chuanjianghe1024-cmd/fc-sensor-models/assets/bh1750-gy302/model.step

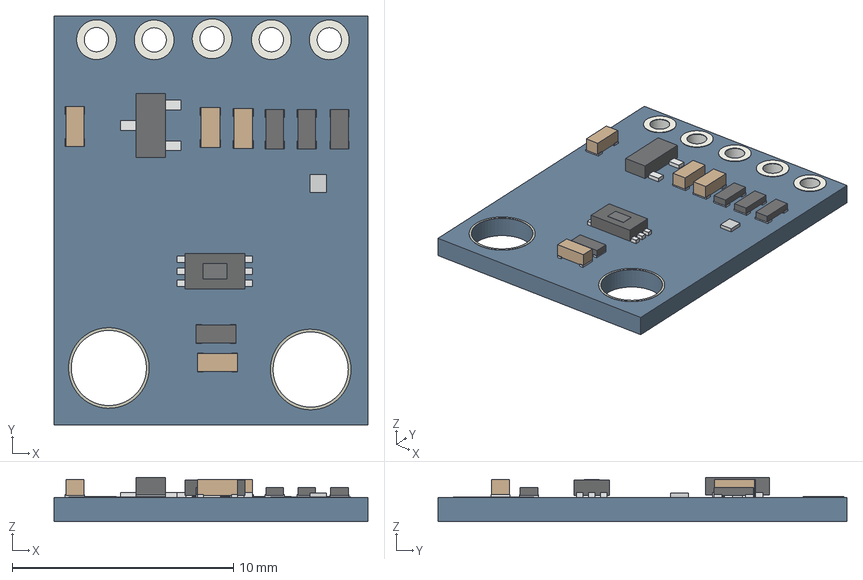
[picture p4: CAD file, 2026-10-26]
assets/bh1750-gy302/model.step
14.2 x 18.5 x 2.00 mm
PCB_14p2x18p5x1p1
P1_plated_hole
P1_top_pad
P1_bottom_pad
P2_plated_hole
P2_top_pad
P2_bottom_pad
P3_plated_hole
P3_top_pad
P3_bottom_pad
P4_plated_hole
P4_top_pad
P4_bottom_pad
P5_plated_hole
P5_top_pad
P5_bottom_pad
H1_rim
H2_rim
Cap_left
Cap_left_endA
Cap_left_endB
Cap_row_1
Cap_row_1_endA
Cap_row_1_endB
Cap_row_2
Cap_row_2_endA
Cap_row_2_endB
Res_row_1
Res_row_1_endA
Res_row_1_endB
Res_row_2
Res_row_2_endA
Res_row_2_endB
Res_row_3
Res_row_3_endA
Res_row_3_endB
Res_near_holes
Res_near_holes_endL
Res_near_holes_endR
Cap_near_holes
Cap_near_holes_endL
Cap_near_holes_endR
Regulator_body
Regulator_lead_1
Regulator_lead_2
Regulator_lead_3
BH1750_body_reference
Sensor_lead_-1_0
Sensor_lead_-1_1
Sensor_lead_-1_2
Sensor_lead_1_0
Sensor_lead_1_1
Sensor_lead_1_2
Optical_region_visual_marker
Solder_bridge_reference
