chuanjianghe1024-cmd/fc-sensor-models/assets/esp32-c3-supermini/model.stl

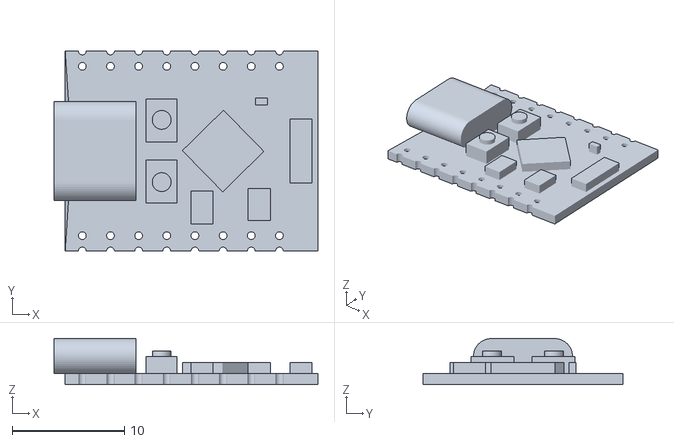
[picture p5: CAD file, 2026-10-26]
assets/esp32-c3-supermini/model.stl
23.5 x 17.8 x 4.10
