chuanjianghe1024-cmd/fc-sensor-models/fc-enclosure/print/step/02_Front_hook_single.step

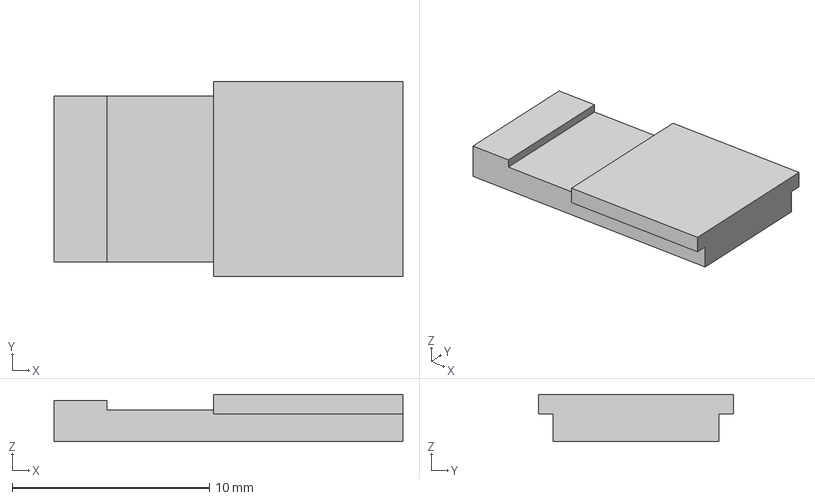
[picture p6: CAD file, 2026-10-26]
fc-enclosure/print/step/02_Front_hook_single.step
17.7 x 9.90 x 2.40 mm
