chuanjianghe1024-cmd/fc-sensor-models/fc-enclosure/print/step/01_Base_single.step

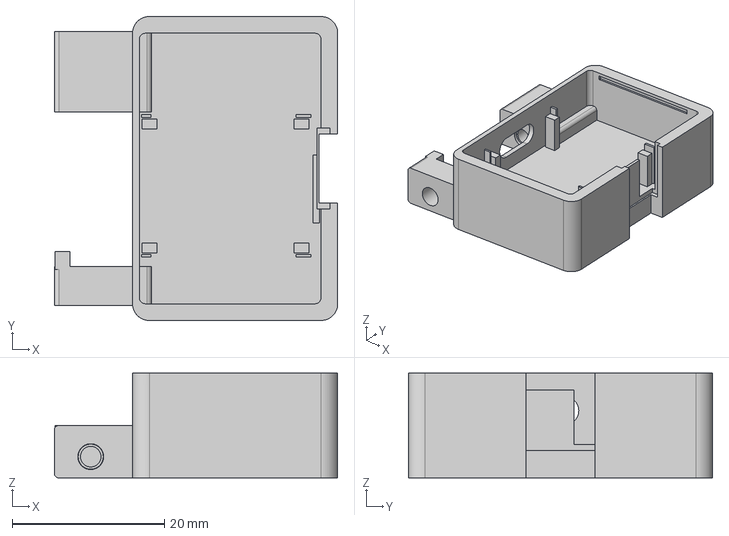
[picture p8: CAD file, 2026-10-26]
fc-enclosure/print/step/01_Base_single.step
37.3 x 40.0 x 13.8 mm
