chuanjianghe1024-cmd/fc-sensor-models/fc-enclosure/print/step/03_H_leg_single.step

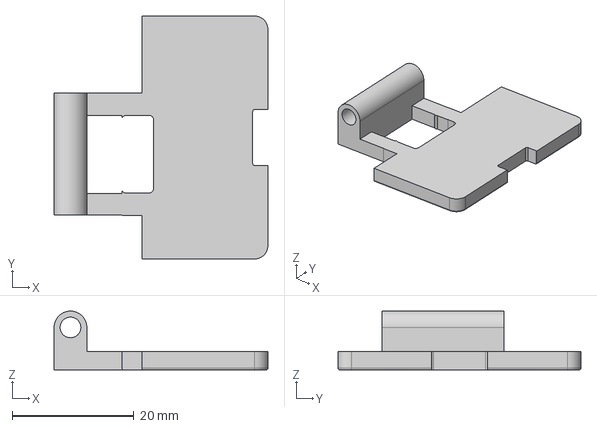
[picture p9: CAD file, 2026-10-26]
fc-enclosure/print/step/03_H_leg_single.step
35.2 x 40.0 x 9.70 mm
