chuanjianghe1024-cmd/fc-sensor-models/fc-enclosure/print/step/04_Lid_color.step

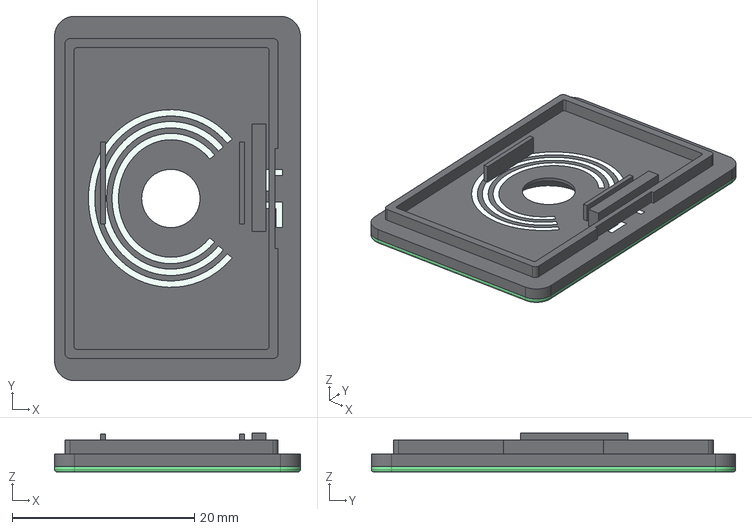
[picture p11: CAD file, 2026-10-26]
fc-enclosure/print/step/04_Lid_color.step
27.0 x 40.0 x 4.28 mm
