chuanjianghe1024-cmd/fc-sensor-models/(list of files, cad)

Other CAD files:
fc-enclosure/model.f3d
fc-enclosure/print/3mf/01_Base_single.3mf
fc-enclosure/print/3mf/02_Front_hook_single.3mf
fc-enclosure/print/3mf/03_H_leg_color.3mf
fc-enclosure/print/3mf/03_H_leg_single.3mf
fc-enclosure/print/3mf/04_Lid_color.3mf
fc-enclosure/print/3mf/04_Lid_single.3mf
fc-enclosure/print/stl/01_Base_single.stl
fc-enclosure/print/stl/02_Front_hook_single.stl
fc-enclosure/print/stl/03_H_leg_single.stl
fc-enclosure/print/stl/04_Lid_single.stl
