chuanjianghe1024-cmd/fc-sensor-models/fc-enclosure/ASSEMBLY.md

# FC 外壳装配说明 / FC enclosure assembly

适用于当前 L7，单位 mm。主模型与版本信息见 [README](README.md)。以下尺寸和工艺来自已有设计记录，实物仍待验证。

Applies to current L7, in mm. See [README](README.md) for the master and version. The following dimensions and process notes come from existing design records; physical validation remains pending.

## 尺寸与装配约束 / Dimensions and assembly constraints

- 单位 mm；沿用 F3D 原坐标，禁止随意移动参考板。
- C3 PCB 22.5×17.8，含 USB 长 23.5；BH1750 为 18.5×14.2。飞线、焊点与绝缘层另留空间。
- 底壳含轴座包络 37.3×40×13.8；上盖平面 27×40；闭合装配高度约 20。
- BH1750 横置于 C3 背面；光孔对感光芯片而非 PCB 中心。孔/芯片中心 X=11.771、Y=11.195，芯片顶到盖内面约 0.42。
- 保留四角支撑、侧向限位、USB 对侧盖内压条。套圈壁厚约 1、插入 1.5、每侧间隙 0.25。
- 两侧内部胶槽各长 19、高 0.7、深 0.35，距外缝留 0.55 挡胶边。先干装，合格后少量涂胶，避免污染感光面/USB/轴。
- 单颗 M3×30 内六角圆柱头螺丝，头下长度 30，无螺母；活动孔 Ø3.4、塑料底孔 Ø2.7，计算啮合约 4.10；开角 0–90°。
- 打印：底壳/脚平底朝下，前挡板侧放，上盖外观面朝下套圈向上；复核桥接、USB 顶部、轴孔及多色映射。

- Use mm and preserve the F3D coordinate system; do not arbitrarily move reference boards.
- C3 PCB: 22.5×17.8, length with USB: 23.5; BH1750: 18.5×14.2. Allow extra space for wires, solder and insulation.
- Base envelope including pivot supports: 37.3×40×13.8; lid footprint: 27×40; closed assembly height: approximately 20.
- BH1750 sits across the back of C3. Align the aperture with the sensing IC, not the PCB center. Aperture/IC center: X=11.771, Y=11.195; IC-to-inner-lid clearance: approximately 0.42.
- Preserve four-corner supports, lateral stops and the lid pressure rib opposite USB. Skirt wall: approximately 1; insertion: 1.5; clearance: 0.25 per side.
- Each internal glue groove: length 19, height 0.7, depth 0.35; retain a 0.55 glue barrier at the external seam. Dry-fit first, then apply a small amount of glue; keep it off the sensor, USB and pivot.
- One M3×30 socket-head cap screw, under-head length 30, no nut. Moving hole Ø3.4, plastic pilot Ø2.7, calculated engagement approximately 4.10; opening range 0–90°.
- Print base/leg flat-side down, front stop on its side, lid exterior-face down with skirt upward. Recheck bridging, USB top, pivot holes and color/material mapping.
