chuanjianghe1024-cmd/fc-sensor-models/(commit log)

2026-10-26 保存 C3、BH1750 与 L6 原型基线
    [02_Front_hook_single.3mf, 02_Front_hook_single.step, 02_Front_hook_single.stl, 04_Lid_color.3mf, 04_Lid_color.step, 04_Lid_single.3mf, 04_Lid_single.step, 04_Lid_single.stl]
2026-10-26 保存 L7 套口粘接外壳并整理模型仓库
    [01_Base_single.3mf, 01_Base_single.step, 01_Base_single.stl, 02_Front_hook_single.3mf, 02_Front_hook_single.step, 02_Front_hook_single.stl, 03_H_leg_color.3mf, 03_H_leg_color.step]
2026-10-31 refactor(models): keep one current model per topic and version via tags
    Reduce tracked files from 84 to 15; preserve model/image blobs and existing L6/L7 history. Consolidate model notes and define Fusion/Codex release workflow with layout checks. Document missing orthographic views and legacy reference formats without claiming CAD revalidation.
    [01_Base_single.3mf, 01_Base_single.step, 01_Base_single.stl, 02_Front_hook_single.3mf, 02_Front_hook_single.step, 02_Front_hook_single.stl, 03_H_leg_color.3mf, 03_H_leg_color.step]
2026-10-31 refactor(models): separate shared assets and root-level model projects
    Move C3/BH1750 references into assets, extract enclosure assembly guide, allow optional project wiring/docs, and turn root README into a project showcase. Update Fusion/Codex conventions and validate release showcase links without modifying CAD assets.
    [model.f3d, model.step, model.stl]
2026-10-31 feat(models): track current print exports and validation/production plate plans
    Restore unchanged L7 STL/STEP/3MF exports. Add documented plate plans pending printer configuration and slicing; update project workflow and layout validation.
    [01_Base_single.3mf, 01_Base_single.step, 01_Base_single.stl, 02_Front_hook_single.3mf, 02_Front_hook_single.step, 02_Front_hook_single.stl, 03_H_leg_color.3mf, 03_H_leg_color.step]
2026-10-31 docs: make project, asset and printing guides bilingual
    Add paired Chinese/English documentation across all 11 Markdown files and require synchronized bilingual updates. Preserve model files, commands, version fields and pending validation status.
